maungnelynnaung/indra-mini-backup-power/bill_of_materials.xlsx

Sheet: data
ID | Category | Components | Unit | Quantity | Unit Cost | Total Cost | Periurban Design | Urban Design | Rural Design
1 | Battery/Storage | Battery (100Ah) | pcs | 1 | 250000 | 250000 | Yes | Yes | Yes
2 | Battery/Storage | Battery Charger (15A) | pcs | 1 | 32000 | 32000 | Yes | Yes | No
3 | Panel Board | Inverter (12V 1000VA Modified Sine) | pcs | 1 | 75700 | 75700 | Yes | Yes | Yes
4 | Panel Board | MCB Breaker (Type C 16A) | pcs | 1 | 10000 | 10000 | Yes | Yes | Yes
5 | Panel Board | MCCB Breaker (30A) | pcs | 1 | 15000 | 15000 | Yes | No | No
6 | Panel Board | AC Outlet (16A) | pcs | 1 | 5000 | 5000 | Yes | Yes | Yes
7 | Panel Board | Switch | pcs | 1 | 1500 | 1500 | Yes | Yes | Yes
8 | Panel Board | Relay (AC 220V, DC 28V, 10A) | pcs | 1 | 7500 | 7500 | Yes | Yes | No
9 | Panel Board | AC Voltmeter (Digital) 220V | pcs | 1 | 5000 | 5000 | Yes | Yes | Yes
10 | Panel Board | DC Voltmeter (Digital) 12V | pcs | 1 | 5000 | 5000 | Yes | No | Yes
11 | Panel Board | AC Cable | yard | 1 | 1000 | 1000 | Yes | Yes | Yes
12 | Panel Board | DC Cable | yard | 1.5 | 5000 | 7500 | Yes | Yes | Yes
13 | Panel Board | Wooden Box | pcs | 1 | 6500 | 6500 | Yes | Yes | Yes
14 | Panel Board | Terminal Block (4 Way) | pcs | 1 | 4000 | 4000 | Yes | Yes | Yes
15 | Panel Board | DIN Rail | meter | 1 | 3000 | 3000 | Yes | Yes | Yes
16 | Panel Board | Screw, Bolt and Nuts | lump sum | 1 | 3500 | 3500 | Yes | Yes | Yes
17 | Solar | Solar Charge Controller (20A) | pcs | 1 | 23000 | 23000 | Yes | No | Yes
18 | Solar | Solar Panel (12-30V 270W) | pcs | 1 | 251000 | 251000 | Yes | No | Yes
19 | Solar | Mount | pcs | 1 | 45000 | 45000 | Yes | No | Yes
 |  |  |  |  | Total Cost | 751200

Sheet: pivot
Components | Cost
Battery/Storage | 282000
Panel Board | 150200
Solar | 319000
Grand Total | 751200
