maungnelynnaung/indra-mini-backup-power/(list of files, drawings)

Other design files:
model_01_proteus.pdsprj
model_02_proteus.pdsprj
model_03_Proteus.pdsprj
